sheemia/ICM45686-Module/Software/JYTechStudio_output/MSPM0/CCS/CCS_ICM45686_IIC/ICM45686_IIC/README.md

# MSPM0G3507 CCS IIC 驱动示例

本工程通过 IIC 读取 ICM45686 的三轴加速度、三轴角速度和温度，不包含姿态解算。

接线：SDA=`PA0`，SCL=`PA1`；串口为 115200 8N1。使用 CCS 导入当前工程，编译并烧录即可观察 `acc(mg)`、`gyro(dps)`、`temp(C)` 输出。

驱动结构、接口和默认传感器配置见 [ICM45686_example 总说明](../../../../../README.md)。
