sheemia/ICM45686-Module/Software/JYTechStudio_output/MSPM0/KEIL/icm45686_iic/icm45686_iic/README.md

# MSPM0G3507 Keil IIC 驱动示例

本工程通过 IIC 读取 ICM45686 的三轴加速度、三轴角速度和温度，不包含姿态解算。

接线：SDA=`PA0`，SCL=`PA1`；串口为 115200 8N1。使用 Keil MDK 打开工程，编译并烧录即可观察 `acc(mg)`、`gyro(dps)`、`temp(C)` 输出。

驱动结构、接口和默认传感器配置见 [ICM45686_example 总说明](../../../../README.md)。
