sheemia/ICM45686-Module/最新发布资料.md

# 最新发布资料

- [示例代码](Software/)
- [.gitattributes](.gitattributes)
- [JYTech_ICM45686_纯传感器模块用户手册_V1.1.pdf](JYTech_ICM45686_%E7%BA%AF%E4%BC%A0%E6%84%9F%E5%99%A8%E6%A8%A1%E5%9D%97%E7%94%A8%E6%88%B7%E6%89%8B%E5%86%8C_V1.1.pdf)
- [JYTechAhrsStudioV1.1.1_Setup.exe](Tools/JYTechAhrsStudioV1.1.1_Setup.exe)
- [JYTechAhrsStudio_v1.1.2_Setup.exe](Tools/JYTechAhrsStudio_v1.1.2_Setup.exe)
- [JYTechAhrsStudio_v1.2.0_Setup.exe](Tools/JYTechAhrsStudio_v1.2.0_Setup.exe)
- [JYTechAhrsStudio_v1.2.1_Setup.exe](Tools/JYTechAhrsStudio_v1.2.1_Setup.exe)
- [JYTechAhrsStudio_v1.2.2_Setup.exe](Tools/JYTechAhrsStudio_v1.2.2_Setup.exe)
- [JYTechAhrsStudio_v1.3.0_Setup.exe](Tools/JYTechAhrsStudio_v1.3.0_Setup.exe)
- [JYTechAhrsStudio_v1.4.0_Setup.exe](Tools/JYTechAhrsStudio_v1.4.0_Setup.exe)
- [JYTechAhrsStudio_v1.4.1_Setup.exe](Tools/JYTechAhrsStudio_v1.4.1_Setup.exe)
- [JYTechAhrsStudio_v1.4.2_Setup.exe](Tools/JYTechAhrsStudio_v1.4.2_Setup.exe)
- [JYTechAhrsStudio_v1.4.3_Setup.exe](Tools/JYTechAhrsStudio_v1.4.3_Setup.exe)
- [JYTechAhrsStudio_v1.4.4_Setup.exe](Tools/JYTechAhrsStudio_v1.4.4_Setup.exe)
- [JYTechAhrsStudio_v1.5.1_Setup.exe](Tools/JYTechAhrsStudio_v1.5.1_Setup.exe)
- [JYTechAhrsStudio_v1.5.2_Setup.exe](Tools/JYTechAhrsStudio_v1.5.2_Setup.exe)
- [JYTechAhrsStudio_v1.5.3_Setup.exe](Tools/JYTechAhrsStudio_v1.5.3_Setup.exe)
- [JYTechAhrsStudio_v1.6.4_Setup.exe](Tools/JYTechAhrsStudio_v1.6.4_Setup.exe)
- [JYTech_AHRS_Studio_通讯协议_V1.1.pdf](Tools/JYTech_AHRS_Studio_%E9%80%9A%E8%AE%AF%E5%8D%8F%E8%AE%AE_V1.1.pdf)
- [JYTech_AHRS_Studio_通讯协议_V1.2.pdf](Tools/JYTech_AHRS_Studio_%E9%80%9A%E8%AE%AF%E5%8D%8F%E8%AE%AE_V1.2.pdf)
