sheemia/ICM45686-Module/Hardware/BOM_Board1_Schematic1.xlsx

No. | Quantity | Comment | Designator | Footprint | Value | Manufacturer Part | Manufacturer | Supplier Part | Supplier
1 | 2 | 100nF | C1,C2 | C0402 | 100nF
2 | 2 | 10uF | C3,C6 | C0402 | 10uF
3 | 1 | 470pF | C13 | C0402 | 470pF
4 | 2 | HDR-M_2.54_1x5P | H1,H2 | HDR-TH_5P-P2.54-V-M |  |  |  | C358687
5 | 1 | LED_0402-G | LED1 | LED_0402
6 | 3 | 10K | R1,R2,R3 | R0402 | 10K
7 | 2 | 4.7K | R4,R5 | R0402 | 4.7K
8 | 1 | ICM-45686 | U1 | LGA-14_L3.0-W2.5-P0.50-TL |  | ICM-45686 | TDK InvenSense(应美盛) | C22459454 | LCSC
9 | 1 | MIC5205-3.3YM5-TR | U4 | SOT-23-5_L3.0-W1.7-P0.95-LS2.8-TL |  | MIC5205-3.3YM5-TR | MICROCHIP(美国微芯) | C37970 | LCSC
