sheemia/ICM45686-Module/Hardware/SCH_Schematic1.pdf

# LED

拓展电路 | 降压电路

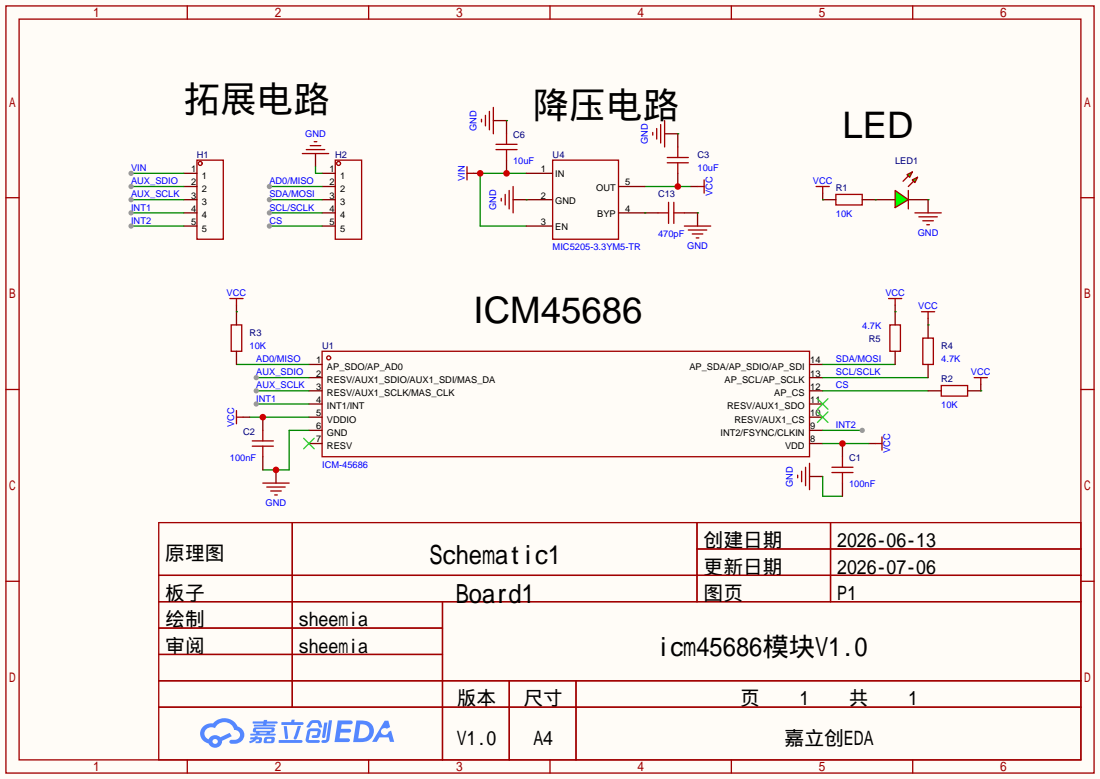
[picture p7: page 1]

原理图 | Schematic1 | 创建日期 | 2026-06-13

更新日期 | 2026-07-06

板子 | Board1 | 图页 | P1
绘制 | sheemia | icm45686模块V1.0
审阅 | sheemia

V1.0 | A4 | 嘉立创EDA
