sheemia/ICM45686-Module/Software/JYTechStudio_output/MSPM0/KEIL/icm45686_SPI/icm45686_SPI/ti_msp_dl_config.h

/*
 * Copyright (c) 2023, Texas Instruments Incorporated - http://www.ti.com
 * All rights reserved.
 *
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
 * *  Redistributions of source code must retain the above copyright
 *    notice, this list of conditions and the following disclaimer.
 *
 * *  Redistributions in binary form must reproduce the above copyright
 *    notice, this list of conditions and the following disclaimer in the
 *    documentation and/or other materials provided with the distribution.
 *
 * *  Neither the name of Texas Instruments Incorporated nor the names of
 *    its contributors may be used to endorse or promote products derived
 *    from this software without specific prior written permission.
 *
 * THIS SOFTWARE IS PROVIDED BY THE COPYRIGHT HOLDERS AND CONTRIBUTORS "AS IS"
 * AND ANY EXPRESS OR IMPLIED WARRANTIES, INCLUDING, BUT NOT LIMITED TO,
 * THE IMPLIED WARRANTIES OF MERCHANTABILITY AND FITNESS FOR A PARTICULAR
 * PURPOSE ARE DISCLAIMED. IN NO EVENT SHALL THE COPYRIGHT OWNER OR
 * CONTRIBUTORS BE LIABLE FOR ANY DIRECT, INDIRECT, INCIDENTAL, SPECIAL,
 * EXEMPLARY, OR CONSEQUENTIAL DAMAGES (INCLUDING, BUT NOT LIMITED TO,
 * PROCUREMENT OF SUBSTITUTE GOODS OR SERVICES; LOSS OF USE, DATA, OR PROFITS;
 * OR BUSINESS INTERRUPTION) HOWEVER CAUSED AND ON ANY THEORY OF LIABILITY,
 * WHETHER IN CONTRACT, STRICT LIABILITY, OR TORT (INCLUDING NEGLIGENCE OR
 * OTHERWISE) ARISING IN ANY WAY OUT OF THE USE OF THIS SOFTWARE,
 * EVEN IF ADVISED OF THE POSSIBILITY OF SUCH DAMAGE.
 */

/*
 *  ============ ti_msp_dl_config.h =============
 *  Configured MSPM0 DriverLib module declarations
 *
 *  DO NOT EDIT - This file is generated for the MSPM0G350X
 *  by the SysConfig tool.
 */
#ifndef ti_msp_dl_config_h
#define ti_msp_dl_config_h

#define CONFIG_MSPM0G350X
#define CONFIG_MSPM0G3507

#if defined(__ti_version__) || defined(__TI_COMPILER_VERSION__)
#define SYSCONFIG_WEAK __attribute__((weak))
#elif defined(__IAR_SYSTEMS_ICC__)
#define SYSCONFIG_WEAK __weak
#elif defined(__GNUC__)
#define SYSCONFIG_WEAK __attribute__((weak))
#endif

#include <ti/devices/msp/msp.h>
#include <ti/driverlib/driverlib.h>
#include <ti/driverlib/m0p/dl_core.h>

#ifdef __cplusplus
extern "C" {
#endif

/*
 *  ======== SYSCFG_DL_init ========
 *  Perform all required MSP DL initialization
 *
 *  This function should be called once at a point before any use of
 *  MSP DL.
 */


/* clang-format off */

#define POWER_STARTUP_DELAY                                                (16)



#define CPUCLK_FREQ                                                     32000000



/* Defines for TIMER_0 */
#define TIMER_0_INST                                                     (TIMG0)
#define TIMER_0_INST_IRQHandler                                 TIMG0_IRQHandler
#define TIMER_0_INST_INT_IRQN                                   (TIMG0_INT_IRQn)
#define TIMER_0_INST_LOAD_VALUE                                           (799U)



/* Defines for UART_0 */
#define UART_0_INST                                                        UART0
#define UART_0_INST_FREQUENCY                                            4000000
#define UART_0_INST_IRQHandler                                  UART0_IRQHandler
#define UART_0_INST_INT_IRQN                                      UART0_INT_IRQn
#define GPIO_UART_0_RX_PORT                                                GPIOA
#define GPIO_UART_0_TX_PORT                                                GPIOA
#define GPIO_UART_0_RX_PIN                                        DL_GPIO_PIN_11
#define GPIO_UART_0_TX_PIN                                        DL_GPIO_PIN_10
#define GPIO_UART_0_IOMUX_RX                                     (IOMUX_PINCM22)
#define GPIO_UART_0_IOMUX_TX                                     (IOMUX_PINCM21)
#define GPIO_UART_0_IOMUX_RX_FUNC                      IOMUX_PINCM22_PF_UART0_RX
#define GPIO_UART_0_IOMUX_TX_FUNC                      IOMUX_PINCM21_PF_UART0_TX
#define UART_0_BAUD_RATE                                                (115200)
#define UART_0_IBRD_4_MHZ_115200_BAUD                                        (2)
#define UART_0_FBRD_4_MHZ_115200_BAUD                                       (11)




/* Defines for SPI */
#define SPI_INST                                                           SPI1
#define SPI_INST_IRQHandler                                     SPI1_IRQHandler
#define SPI_INST_INT_IRQN                                         SPI1_INT_IRQn
#define GPIO_SPI_PICO_PORT                                                GPIOB
#define GPIO_SPI_PICO_PIN                                         DL_GPIO_PIN_8
#define GPIO_SPI_IOMUX_PICO                                     (IOMUX_PINCM25)
#define GPIO_SPI_IOMUX_PICO_FUNC                     IOMUX_PINCM25_PF_SPI1_PICO
#define GPIO_SPI_POCI_PORT                                                GPIOB
#define GPIO_SPI_POCI_PIN                                         DL_GPIO_PIN_7
#define GPIO_SPI_IOMUX_POCI                                     (IOMUX_PINCM24)
#define GPIO_SPI_IOMUX_POCI_FUNC                     IOMUX_PINCM24_PF_SPI1_POCI
/* GPIO configuration for SPI */
#define GPIO_SPI_SCLK_PORT                                                GPIOB
#define GPIO_SPI_SCLK_PIN                                         DL_GPIO_PIN_9
#define GPIO_SPI_IOMUX_SCLK                                     (IOMUX_PINCM26)
#define GPIO_SPI_IOMUX_SCLK_FUNC                     IOMUX_PINCM26_PF_SPI1_SCLK



/* Port definition for Pin Group CS */
#define CS_PORT                                                          (GPIOB)

/* Defines for PIN: GPIOB.6 with pinCMx 23 on package pin 58 */
#define CS_PIN_PIN                                               (DL_GPIO_PIN_6)
#define CS_PIN_IOMUX                                             (IOMUX_PINCM23)


/* clang-format on */

void SYSCFG_DL_init(void);
void SYSCFG_DL_initPower(void);
void SYSCFG_DL_GPIO_init(void);
void SYSCFG_DL_SYSCTL_init(void);
void SYSCFG_DL_TIMER_0_init(void);
void SYSCFG_DL_UART_0_init(void);
void SYSCFG_DL_SPI_init(void);


bool SYSCFG_DL_saveConfiguration(void);
bool SYSCFG_DL_restoreConfiguration(void);

#ifdef __cplusplus
}
#endif

#endif /* ti_msp_dl_config_h */
