sheemia/ICM45686-Module/Software/JYTechStudio_output/STM32/ICM45686_STM32F407_HAL/HARDWARE/SPI/spi.h

#ifndef __SPI_H
#define __SPI_H
#include "sys.h"
//////////////////////////////////////////////////////////////////////////////////	 
//本程序只供学习使用，未经作者许可，不得用于其它任何用途
//ALIENTEK STM32F407开发板
//SPI驱动代码	   
//正点原子@ALIENTEK
//技术论坛:www.openedv.com
//创建日期:2017/3/13
//版本：V1.0
//版权所有，盗版必究。
//Copyright(C) 广州市星翼电子科技有限公司 2014-2024
//All rights reserved									  
////////////////////////////////////////////////////////////////////////////////// 	

extern SPI_HandleTypeDef SPI1_Handler;  //SPI句柄

void SPI1_Init(void);
void SPI1_SetSpeed(u8 SPI_BaudRatePrescaler);
u8 SPI1_ReadWriteByte(u8 TxData);
#endif
