sheemia/ICM45686-Module/Software/JYTechStudio_output/MSPM0/KEIL/icm45686_iic/icm45686_iic/BSP/bsp_spi.h

#ifndef _BSP_SPI_H__
#define _BSP_SPI_H__

#include "board.h"

//CS引脚的输出控制 
//x=0时输出低电平
//x=1时输出高电平
#define SPI_CS(x)  ( (x) ? DL_GPIO_setPins(GPIO_SPI_CS0_PORT, GPIO_SPI_CS0_PIN) : DL_GPIO_clearPins(GPIO_SPI_CS0_PORT, GPIO_SPI_CS0_PIN) )
uint8_t spi_read_write_byte(uint8_t dat);
#endif
