sheemia/ICM45686-Module/Software/JYTechStudio_output/MSPM0/CCS/CCS_ICM45686_SPI/ICM45686_SPI/bsp_spi.c

#include "bsp_spi.h"

uint8_t spi_read_write_byte(uint8_t dat)
{
        uint8_t data = 0;
        
        //发送数据
        DL_SPI_transmitData8(SPI_INST,dat);
        //等待SPI总线空闲
        while(DL_SPI_isBusy(SPI_INST));
        //接收数据
        data = DL_SPI_receiveData8(SPI_INST);
        //等待SPI总线空闲
        while(DL_SPI_isBusy(SPI_INST));
        
        return data;
}
