sheemia/ICM45686-Module/(commit log)

2026-10-02 更新 ICM45686 客户资料 2026-10-02 10:00:46
2026-10-02 更新 ICM45686 客户资料 2026-10-02 11:18:07
2026-10-13 更新 ICM45686 客户资料 2026-10-13 23:10:20
2026-10-13 更新 ICM45686 客户资料 2026-10-14 00:17:54
